SJJOHN736/SSH-Model/Screenshot 2025-07-21 121146.png

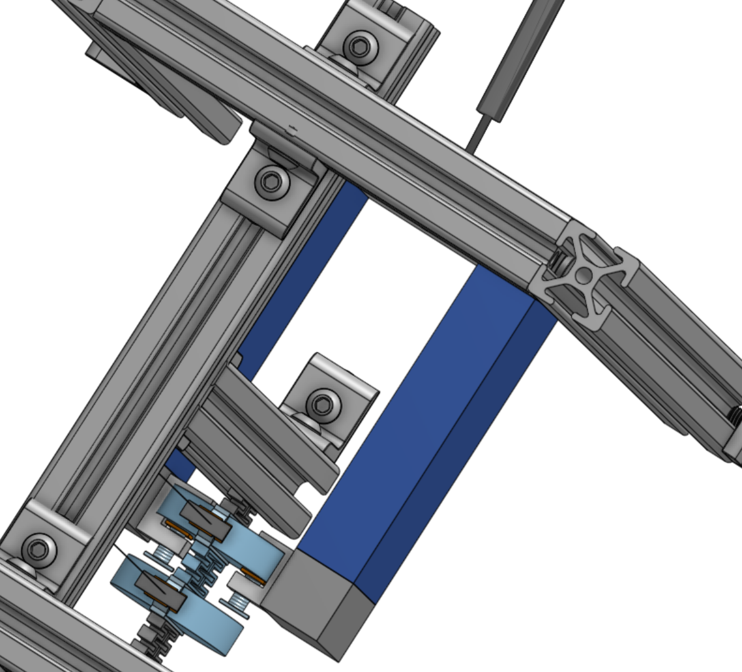
Screenshot 2025-07-21 121146.png
