SJJOHN736/SSH-Model/Screenshot 2025-07-21 121206.png

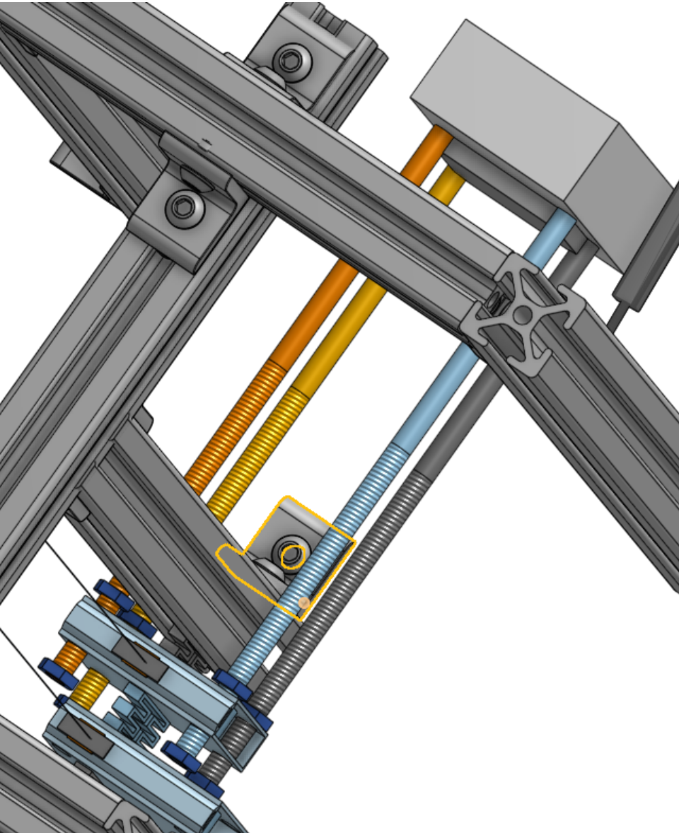
Screenshot 2025-07-21 121206.png
