SJJOHN736/SSH-Model/[PRINT] C-Clamp.stl

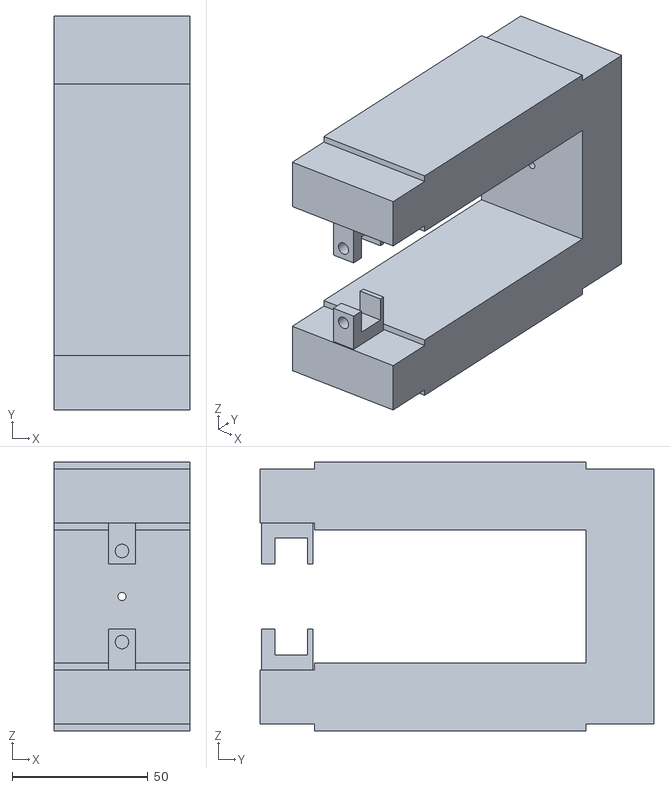
[picture p3: CAD file, 2025-07-21]
[PRINT] C-Clamp.stl
50.0 x 145.0 x 99.0
