SJJOHN736/SSH-Model/3750-8250 6% stiffer.stl

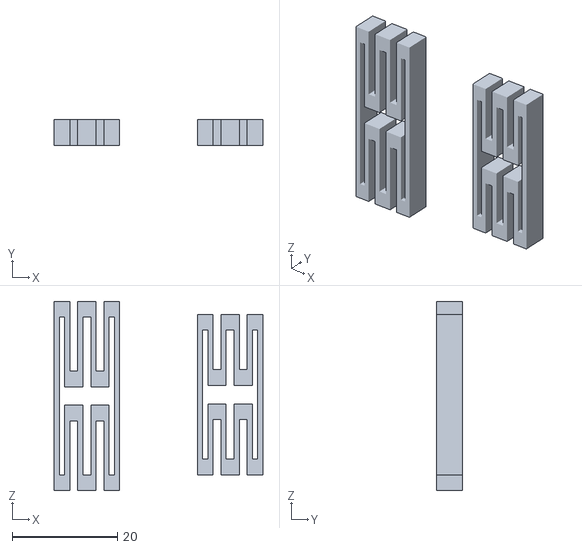
[picture p4: CAD file, 2025-07-21]
3750-8250 6% stiffer.stl
39.8 x 5.00 x 36.1
