SJJOHN736/SSH-Model/Parts for Mass Holder and Clamps.stl

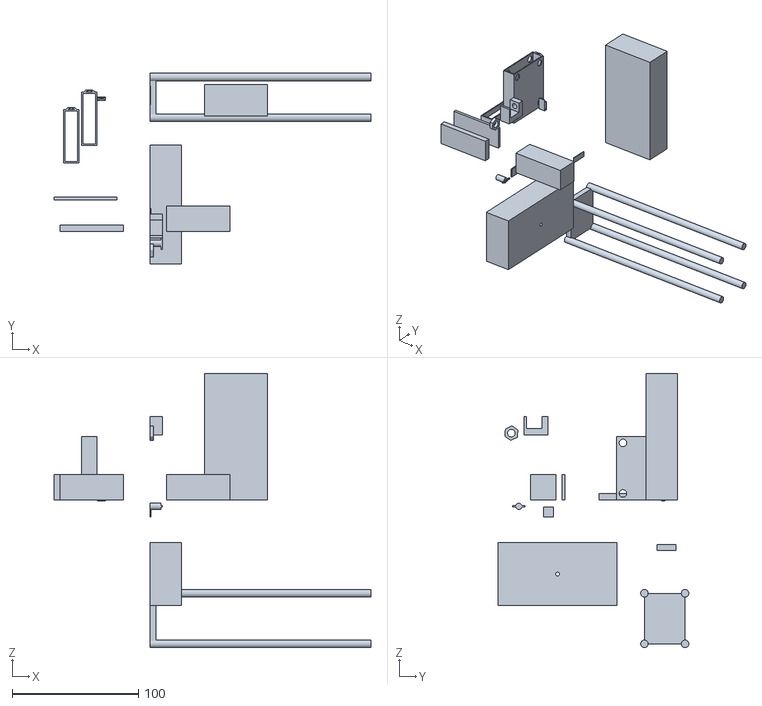
[picture p5: CAD file, 2025-07-21]
Parts for Mass Holder and Clamps.stl
250.8 x 150.8 x 217.0
