SJJOHN736/SSH-Model/{TEST} 3750 N-m and 8250 N-m.stl

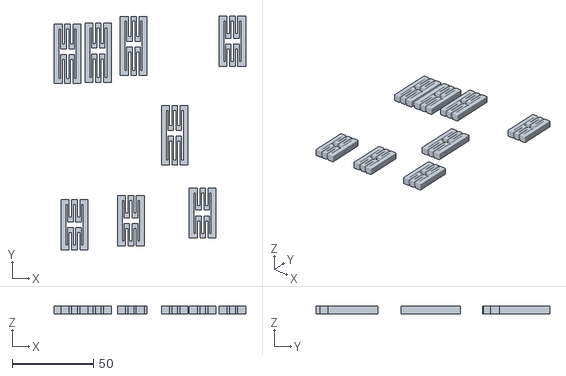
[picture p6: CAD file, 2025-07-21]
{TEST} 3750 N-m and 8250 N-m.stl
118.0 x 144.1 x 5.00
