SJJOHN736/SSH-Model/[PRINT] Springs(6_percent) w- 19 Mass encasement.stl

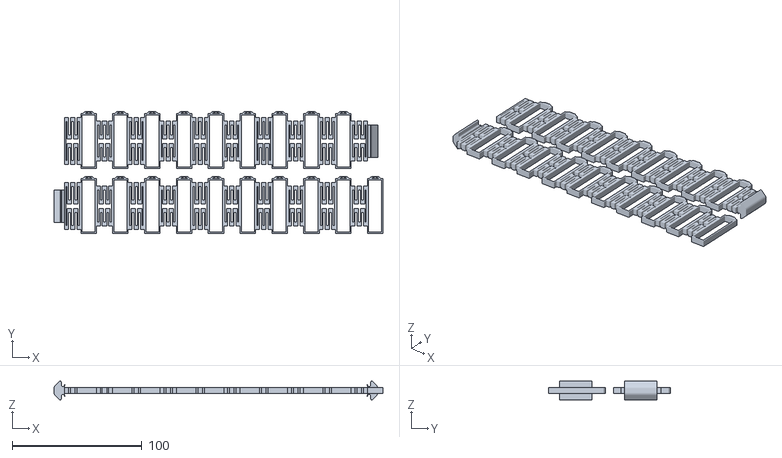
[picture p7: CAD file, 2025-07-21]
[PRINT] Springs(6_percent) w- 19 Mass encasement.stl
253.1 x 93.8 x 14.5
