SJJOHN736/SSH-Model/[TEST] 8745 and 3975 Springs.stl

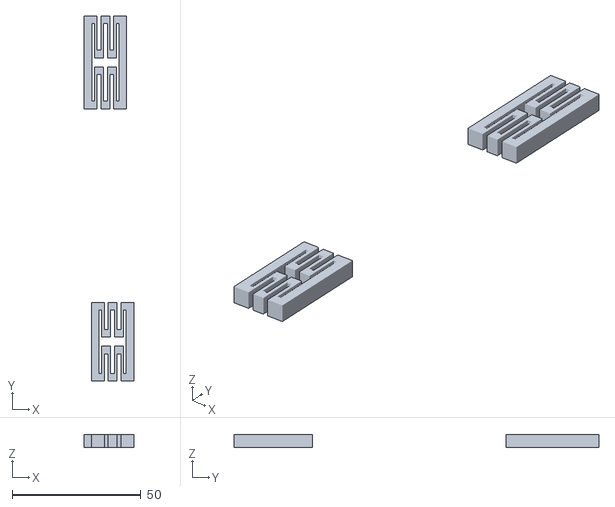
[picture p8: CAD file, 2025-07-21]
[TEST] 8745 and 3975 Springs.stl
19.3 x 141.9 x 5.00
