SJJOHN736/SSH-Model/3750-8250  N-m Springs.stl

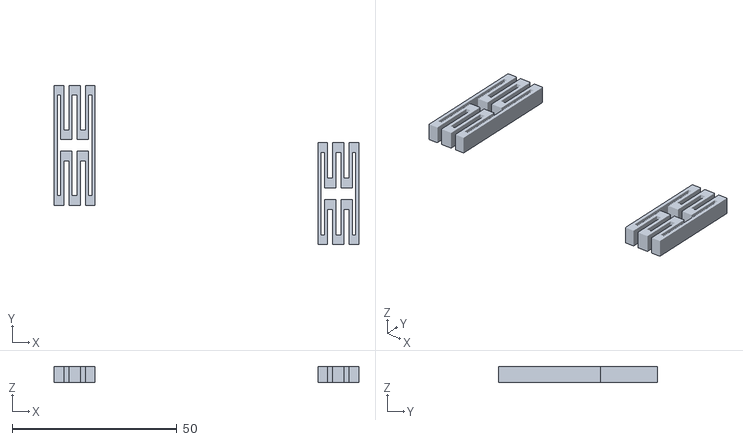
[picture p9: CAD file, 2025-07-21]
3750-8250 N-m Springs.stl
92.6 x 48.4 x 5.00
