SJJOHN736/SSH-Model/Bolt-on Clamp Assembly.stl

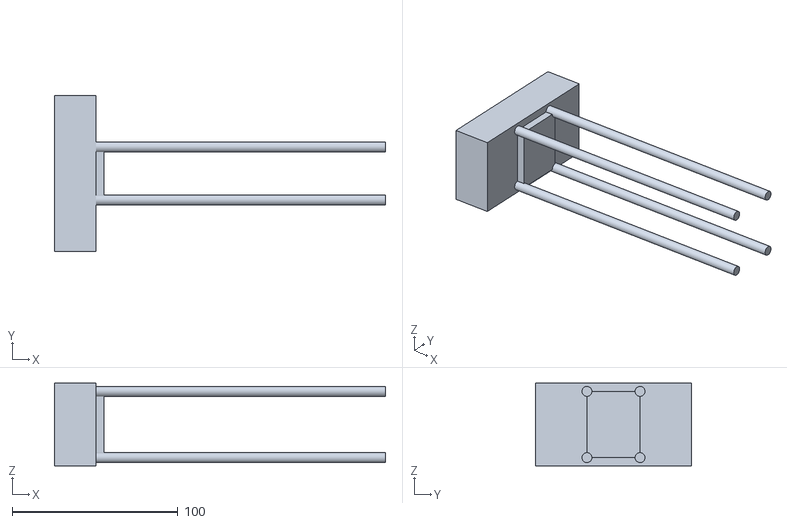
[picture p10: CAD file, 2025-07-21]
Bolt-on Clamp Assembly.stl
200.0 x 94.0 x 50.0
