SJJOHN736/SSH-Model/4844N136_T-Slotted Framing Structural Bracket.stl

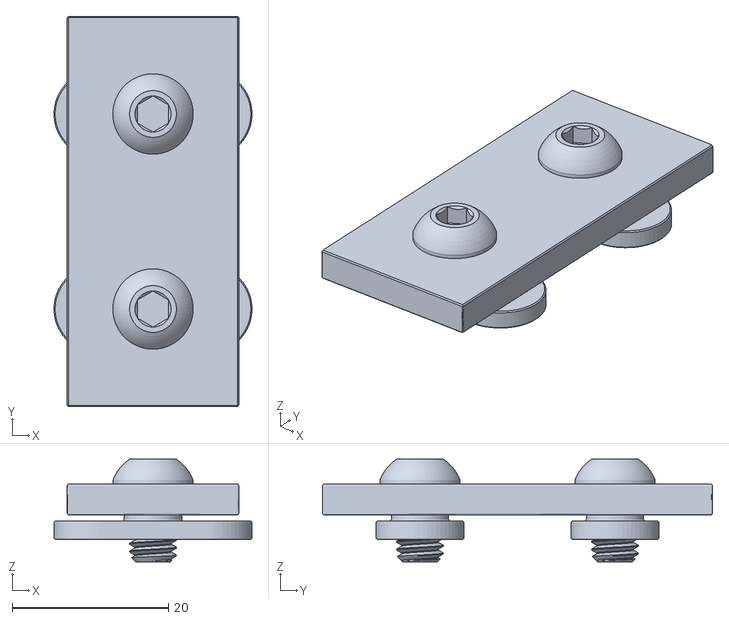
[picture p11: CAD file, 2025-07-21]
4844N136_T-Slotted Framing Structural Bracket.stl
25.4 x 50.0 x 13.2
