SJJOHN736/SSH-Model/C-Clamp w. Bolt.stl

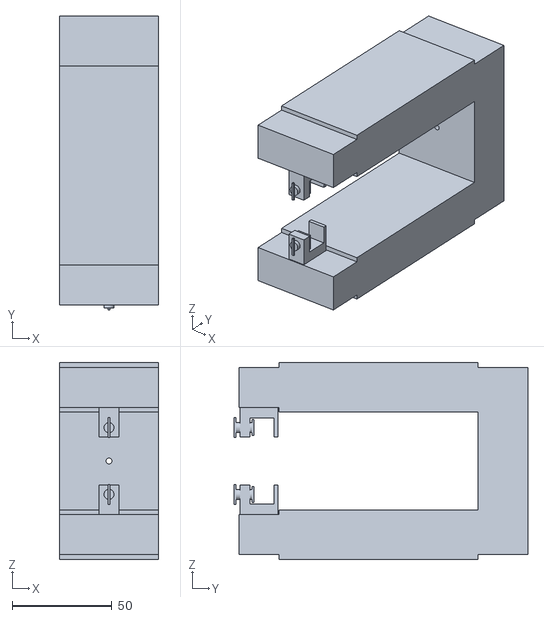
[picture p12: CAD file, 2025-07-21]
C-Clamp w. Bolt.stl
50.0 x 147.5 x 99.0
