SJJOHN736/SSH-Model/4844N123_T-Slotted Framing Structural Bracket.stl

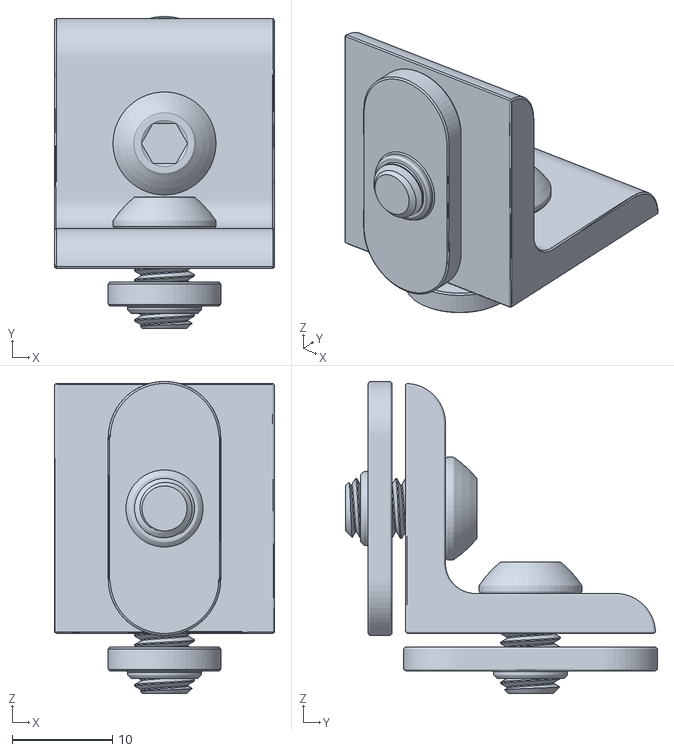
[picture p13: CAD file, 2025-07-21]
4844N123_T-Slotted Framing Structural Bracket.stl
22.0 x 31.2 x 31.2
