SJJOHN736/SSH-Model/4633N78_T-Slotted Framing Rail.stl

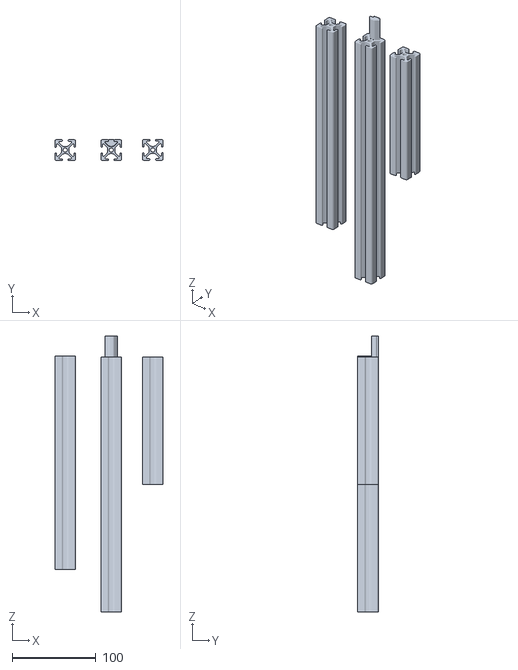
[picture p14: CAD file, 2025-07-21]
4633N78_T-Slotted Framing Rail.stl
129.6 x 25.2 x 329.8
