SJJOHN736/SSH-Model/Topological Physcis SSH Model  - Recreation Guide  (1).pdf

# Acoustic SSH Model Design/Assembly Guide

# Snehith John & Arturo Whipple

Github Repository: https://github.com/SJJOHN736/SSH-Model Any questions? Email snehithjj@gmail.com or avwhi331@arizona.edu

# Overview

Matlab Simulations & Code
Spring Testing & Design
Experimental Design & Assembly

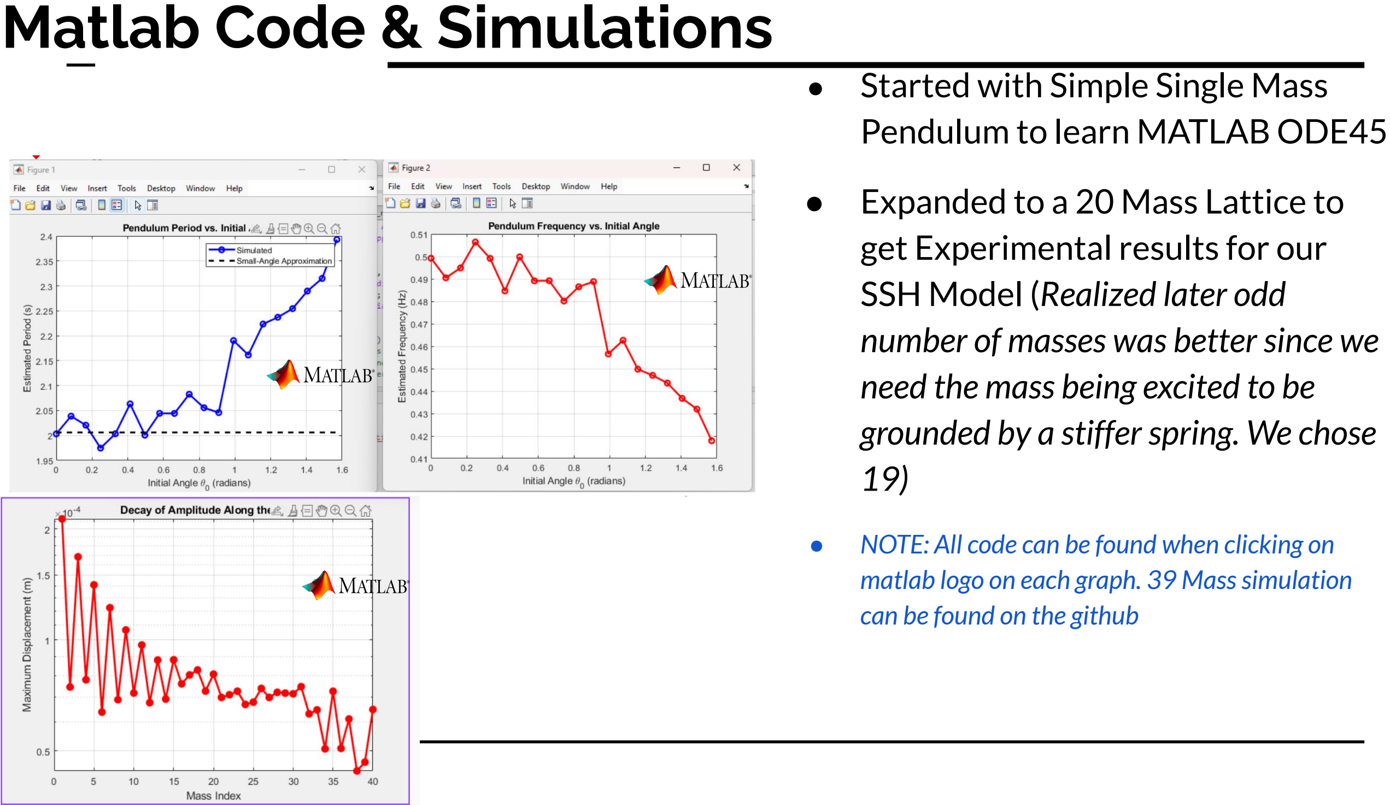
[picture p15: figure]
Matlab Code & Simulations; ● Started with Simple Single Mass Pendulum to learn MATLAB ODE45; ● Expanded to a 20 Mass Lattice to get Experimental results for our SSH Model (Realized later odd number of masses was better since we need the mass being excited to be grounded by a stiffer spring. We chose 19); can be found on the github

- NOTE: All code can be found when clicking on matlab logo on each graph. 39 Mass simulation

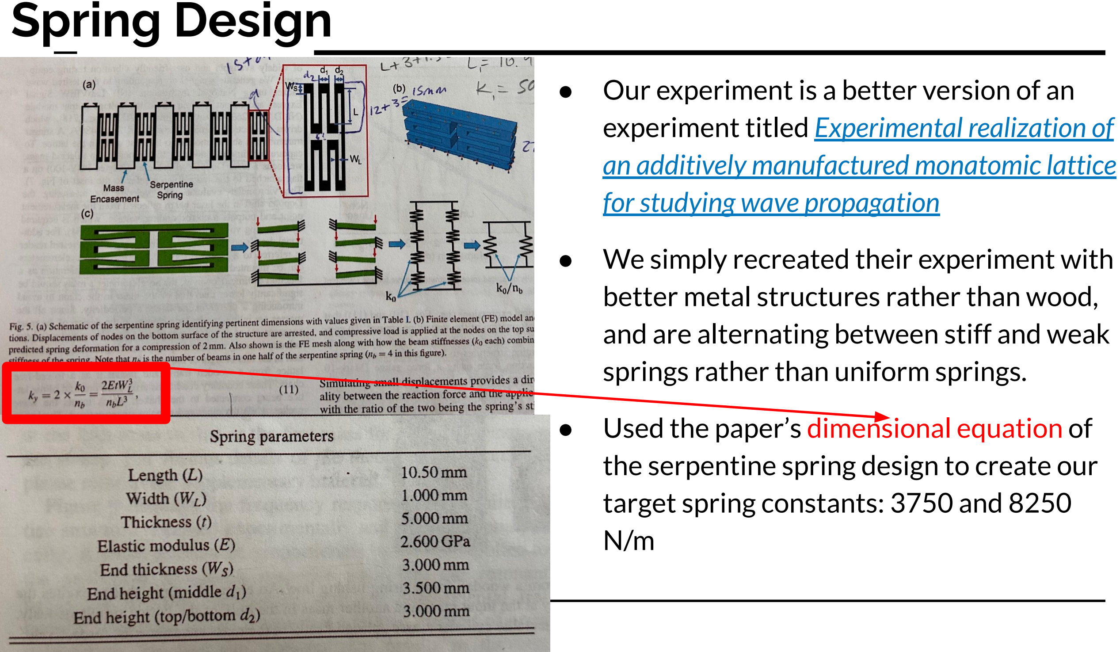
[picture p16: figure]
Spring Design; for studying wave propagation; springs rather than uniform springs.; target spring constants: 3750 and 8250 N/m

- Our experiment is a better version of an experiment titled Experimental realization of an additively manufactured monatomic lattice
- We simply recreated their experiment with better metal structures rather than wood, and are alternating between stiff and weak
- Used the paper’s dimensional equation of the serpentine spring design to create our

# Spring Testing

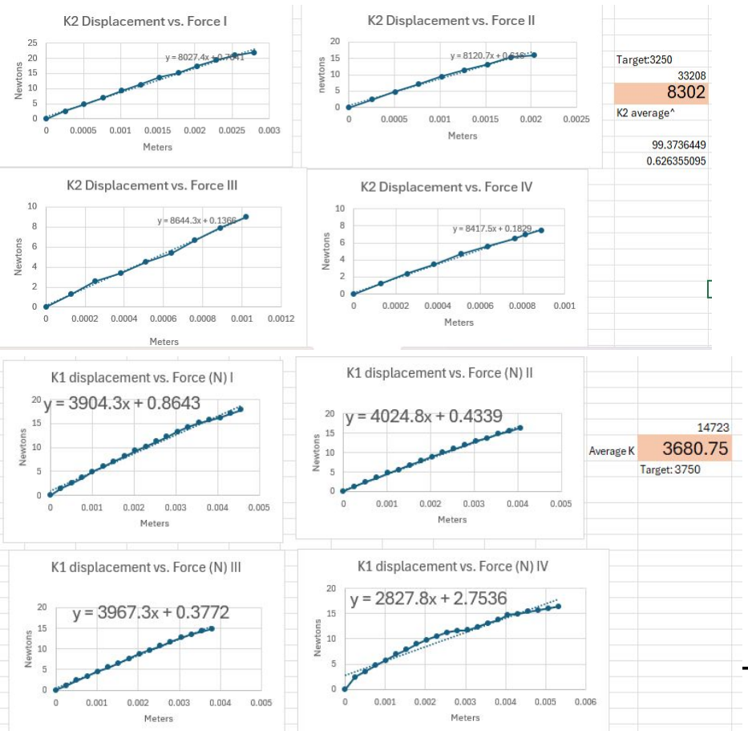
[picture p17: figure]

- Our target spring constants were 3750 and 8250 N/m to observe the edge mode.
- After testing, saw a 6% discrepancy between theoretical spring stiffness and tested stiffness.
- Redesigned both springs to be theoretically 6% stiffer and got low margins of error after testing.

NOTE: Spring Files in the Github that start with “[TEST]” are spring designs meant for testing only since both ends were made thicker to take into consideration the thickness of the mass casing. The springs used for the experiment start with “[PRINT]”

# Experimental Design

- Using OnShape, we designed our experiment to figure out exactly how much material to buy and how our experiment would look. You can see our design with this link (https://cad.onshape.com/documents/f64d6fb7c5ec95d64199eb87/w/bccc6e681dc741138032d5c0/e/5db906cd49e5b81b36df5f6d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)
- We also designed different “clamping” mechanisms to clamp the 19th mass to the shaker so that it can be excited these designs can be found here (https://cad.onshape.com/documents/ed1cc6db6fec7e286088fa9e/w/619889c0b768f6636e40f5fd/e/8d82a1f609c83625c5fbcf44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) and to see how they work in the larger assembly can be seen with this link. (https://cad.onshape.com/documents/f64d6fb7c5ec95d64199eb87/w/bccc6e681dc741138032d5c0/e/5db906cd49e5b81b36df5f6d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)
- Flags were also designed so the Laser Doppler Vibrometer can measure the velocity of each mass. Dummy flags were also created to keep a uniform mass on the masses.

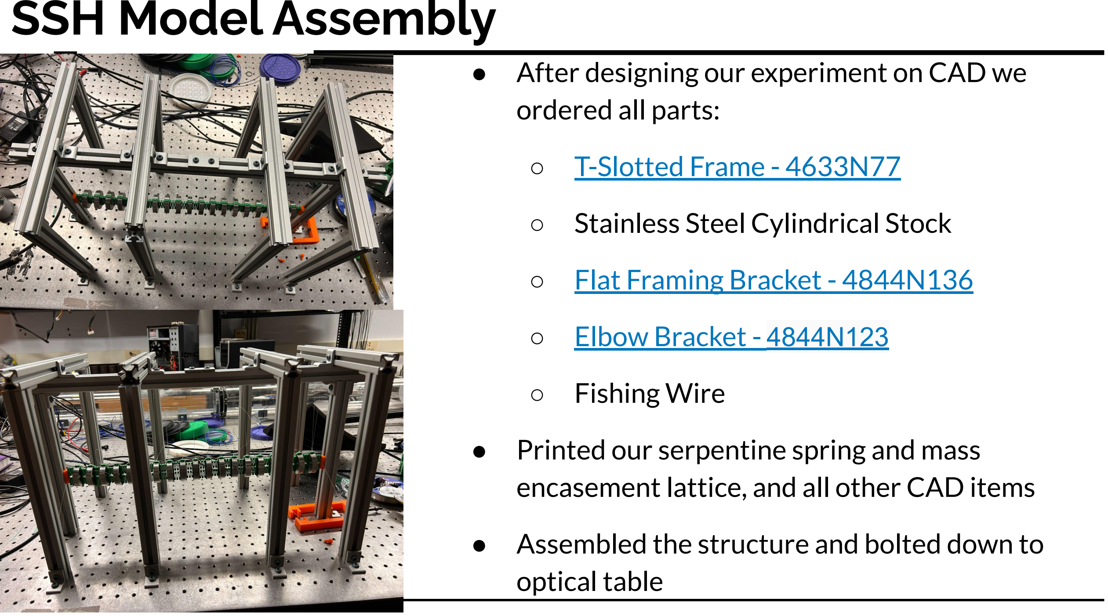
[picture p18: figure]
SSH Model Assembly; ordered all parts:; ○ T-Slotted Frame - 4633N77; ○ Stainless Steel Cylindrical Stock; ○ Flat Framing Bracket - 4844N136; ○ Elbow Bracket - 4844N123; ○ Fishing Wire; optical table

- After designing our experiment on CAD we
- Printed our serpentine spring and mass encasement lattice, and all other CAD items
- Assembled the structure and bolted down to
