SJJOHN736/SSH-Model/(commit log)

2025-07-21 Rename Screenshot 2025-07-21 121125.png to 39 Mass Chain
2025-07-21 Add files via upload
    This worksheet shows how we calculated what Spring constants was needed to observe an edge state. ie. 3750 N/m and 8250 N/m
